fernd4wg/sound-following-robot/Images/circuit-schematic.jpg

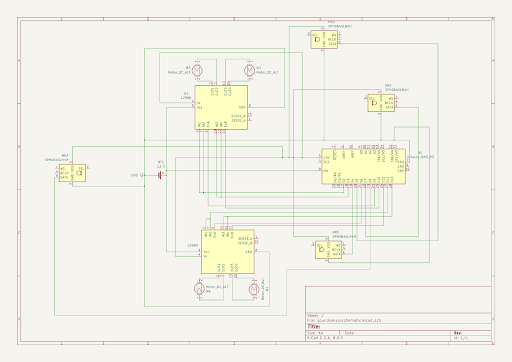
Images/circuit-schematic.jpg
