fernd4wg/sound-following-robot/Images/flow-chart.jpg

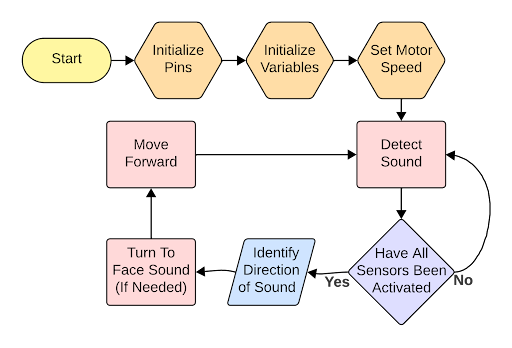
Images/flow-chart.jpg
