fernd4wg/sound-following-robot/Images/gantt.jpg

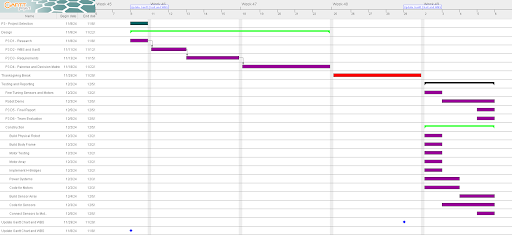
Images/gantt.jpg
