fernd4wg/sound-following-robot/Images/wbs-chart.jpg

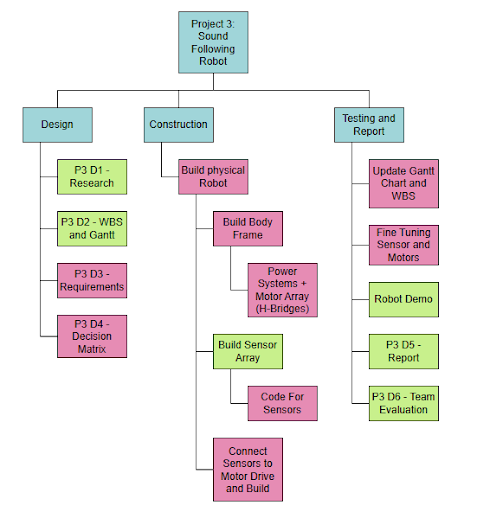
Images/wbs-chart.jpg
